SourceryOne/Arduino-Sample-and-Hold/SITH partslist - Sheet1.pdf

## SITHs Partslist / BOM

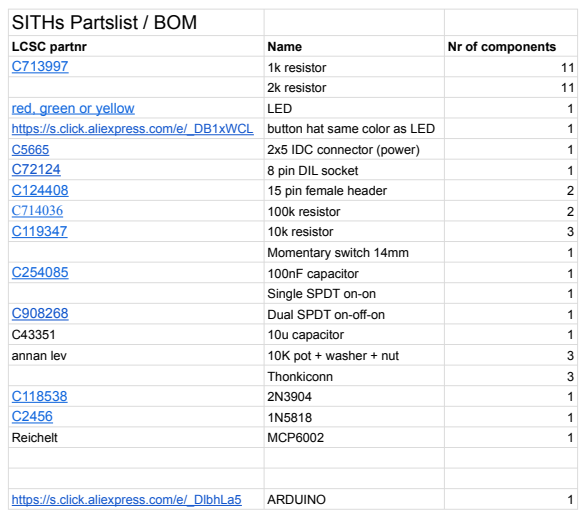
[picture p1: page 1]
LCSC partnr; Name; Nr of components; 1k resistor; 2k resistor; red, green or yellow; LED; https://s.click.aliexpress.com/e/_DB1xWCL button hat same color as LED; 2x5 IDC connector (power); 8 pin DIL socket; 15 pin female header; 100k resistor; 10k resistor; Momentary switch 14mm; 100nF capacitor; Single SPDT on-on; Dual SPDT on-off-on; 10u capacitor; annan lev; 10K pot + washer + nut; Thonkiconn; Reichelt; MCP6002; https://s.click.aliexpress.com/e/_DlbhLa5; ARDUINO
