SourceryOne/Arduino-Sample-and-Hold/Schematic_Arduino-S-H_2024-05-07.pdf

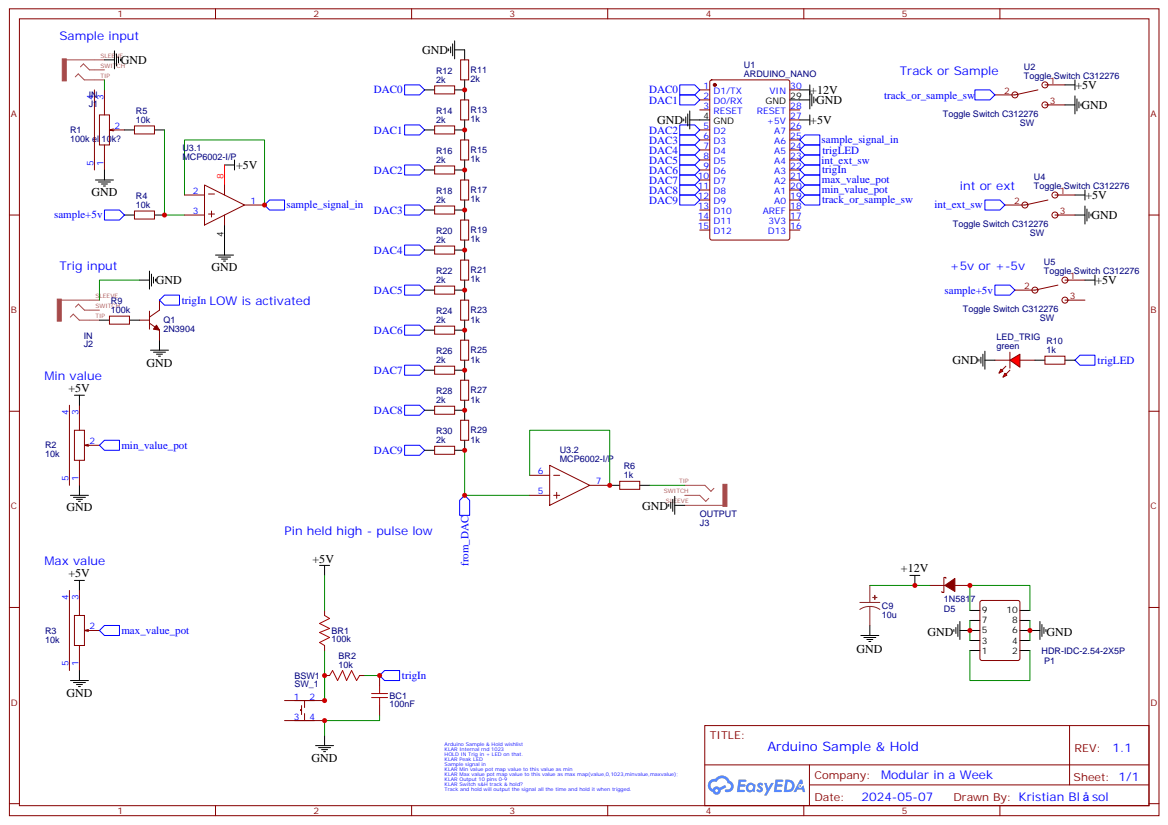
[picture p2: page 1]

Pin held high - pulse low

Arduino Sample & Hold wishlist
KLAR Internal rnd 1023
HOLD IN Trig in + LED on that.
KLAR Peak LED
Sample signal in
KLAR Min value pot map value to this value as min
KLAR Max value pot map value to this value as max map(value,0,1023,minvalue,maxvalue);
KLAR Output 10 pins 0-9
KLAR Switch s&H track & hold?
Track and hold will output the signal all the time and hold it when trigged.

Company: Modular in a Week

Drawn By: Kristian Bl sol
