SourceryOne/Arduino-Sample-and-Hold/SITH/SITH.ino

/*
 * Version history.
 * v1.1 (v0.3 but it is released so... 1....) fixed the mapping of hi and low cut. which might have remoed the twiddle feature?
 * random gates and sample and slide as extra functions
 * v1.2 Added functionality for: LFO & Hold, AD-envelope, Percussive Noise/LoFi VCA.
 * v1.3 playing around with alt function 6 cv record.
 */
