SourceryOne/Arduino-Sample-and-Hold/(commit log)

2024-03-10 Added latest code with all functions
    Includes Sample/Track, Internal/External, Min/Max values, Hold, Internal Noise source.
2024-03-10 New schematics
2024-05-06 Delete arduino-sample-and-hold-with-alternate-function.ino
    was built upon old code with wrong pins.
2024-05-07 New (final) schematics
    includes functioning opamps, and +5v/+-5v switch
2024-05-07 Delete Schematic_Arduino-S-H_2024-03-06.pdf
    old schematics
2024-05-09 BOM Bill of Materials for the SITH module
2024-05-10 BOM for the SITH
2025-01-01 Updated code, eeprom saving, and sample and slide.
    Updated code for the SITH, with eeprom saving of which function was last used. Aswell as a new alternate function Sample and Slide. Also did the changing of alternate codes easier to add more alternate codes and understand it. Also started working in TABS to work with each function more easily.
2025-01-01 Updated code, eeprom saving, and sample and slide.
    Updated code for the SITH, with eeprom saving of which function was last used. Aswell as a new alternate function Sample and Slide. Also did the changing of alternate codes easier to add more alternate codes and understand it. Also started working in TABS to work with each function more easily. This version I also added the HighCut knob to set the time between pulses for the slide to take from 0 to 100%.
2025-06-01 New firmware with multiple alternate functions.
    Each function can be found/used by setting both MAX and MIN pots to minimum value and holding the HOLD button for two seconds for each function. The functions are as follows:
    1 (2s). Sample or Track and Hold (S|TH) - Main function
    2 (4s). Random Gates - like half a branches with only one input and one output.
    3 (6s). Sample and Slide - Like S&H but instead it slides between the values.
    4 (8s). LFO & Hold - An LFO with adjustable edges that you can Hold.
    5 (10s). AD Envelope - A simple AD envelope generator.
    6 (12s). Percussive Noise - Meant to be a hihat, but is probably more of a Snare or clap sound. Very 80's game bomb and gunshot kindo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
    [SITH.ino, SITH_10_config_and_setup.ino, SITH_20_loop.ino, SITH_30_main_function.ino, SITH_40_1_RND_Gates.ino, SITH_40_2_Sample_Slide.ino, SITH_40_3_LFO_Hold.ino, SITH_40_4_AD_envelope.ino]
2025-06-08 The new firmware with the S&S change
    Added the change to the sample and slide suggested by Jos Bouten that adds control for upwards and downwards slide respectively.
2025-09-10 Version 1.3 with a simple CV recorder
    Added another function CV recorder, or CV sampler, a 255 step recorder where when LOWcut is at MAX it will record the incoming signal, when LOWcut is at MIN it will instead remove the first sample in the buffer. Any value in between will play the buffer looped.
    This is alternate function nr 6. Mostly demoed on DMF (Dutch Modular Fest).
